mandrebern/TallyLight/eletronics/Rev A/Bill of Materials TallyLight.xlsx

 | Bill Of Materials |  |  | André-Netline |  |  |  |  |  |  | Confidential & Proprietary
 | Source Data From: |  |  | TallyLight.BomDoc
 | Variant: |  |  | None
 | Revision:
 | Report Date: |  |  | 14.08.2022 | 18:05
 | Print Date: |  |  | 2022-08-14 | 18:08:35
# | Designator | Name | Manufacturer | Manufacturer Part Number | Description | Supplier 1 | Supplier Part Number 1 | Footprint | Fitted | Quantity | Fitted Qty
1 | J2, J3 | BM03B-SRSS-TB | JST | BM03B-SRSS-TB(LF)(SN) | CONN HEADER SMD 3POS 1MM | Digi-Key | 455-1789-1-ND | BM03B-SRSS-TB | Fitted | 2 | 2
2 | U1 (2x) | LolinD32Pro | Sullins | PPPC161LFBN-RC | ESP32 board |  |  | LolinD32Pro | Fitted | 2 | 2
3 | J1 | Header 5 |  |  | Header, 5-Pin |  |  | HDR1X5 | Not Fitted | 1 | 0
4 | MT1, MT2, MT3, MT4 | Mount 3.2mm |  |  | Mounting hole 3.2mm, 5.7mm pad |  |  | MT | Not Fitted | 4 | 0
5 | BT1 (2x) | Battery | Keystone Electronics | 54 | Multicell Battery |  |  | Bat18650B | Fitted | 2 | 2
6 | R7, R8 | 10E | Panasonic | Stackpole Electronics Inc | RES 10 OHM 1% 1/10W 0603 |  |  | R0603 | Fitted | 2 | 2
7 | R1, R2 | (1.5k) | Panasonic | ERJ-2RKF1501X | RES SMD 1.5K OHM 1% 1/10W 0402 | Newark | 85Y8121 | R0402 | Not Fitted | 2 | 0
8 | R5 | 10k | Panasonic | ERJ-2RKF1002X | RES SMD 10K OHM 1% 1/10W 0402 | Newark | 85Y8054 | R0402 | Fitted | 1 | 1
9 | R6 | 20k | Panasonic | ERJ-2RKF2002X | RES SMD 20K OHM 1% 1/10W 0402 | Newark | 12AC0974 | R0402 | Fitted | 1 | 1
10 | R3, R4 | 470E | Panasonic | ERJ-2RKF4700X | RES SMD 470 OHM 1% 1/10W 0402 | Newark | 85Y8343 | R0402 | Fitted | 2 | 2
11 | S2 | 500SSP1S1M6QEA | E-Switch | 500SSP1S1M6QEA | SWITCH SLIDE SPDT 5A 120V | Digi-Key | EG2478-ND | 500SSPxS2M6xEA | Fitted | 1 | 1
12 | S1 | SS075Q102F035V2A | E-Switch | SS075Q102F035V2A | SWITCH SNAP ACT SPDT 100MA 125V | Mouser | 612-SS075Q102F035V2A | SS075Q102F035V2A | Fitted | 1 | 1
 |  |  |  |  |  |  |  |  |  |  | 14
Approved by: |  |  |  | Notes:
 | Author: |  | Date: | The manufacturer part number takes precedence over any supplier part number.
 |  |  |  | All 0603 resistors and capacitors may be replaced by other manufacturer parts, as long as their value, tolerance, oparting temperature and voltage rating is the same or better.
 | Engineering: |  | Date:
 | Manufacturing: |  | Date: |  |  |  |  |  |  |  | André-Netline
 |  |  |  |  |  |  |  |  |  |  | Könizstr. 161
 |  |  |  |  |  |  |  |  |  |  | CH-3097 Liebefeld
 | QA: |  | Date:
