mandrebern/TallyLight/cad/tally_light.FCStd

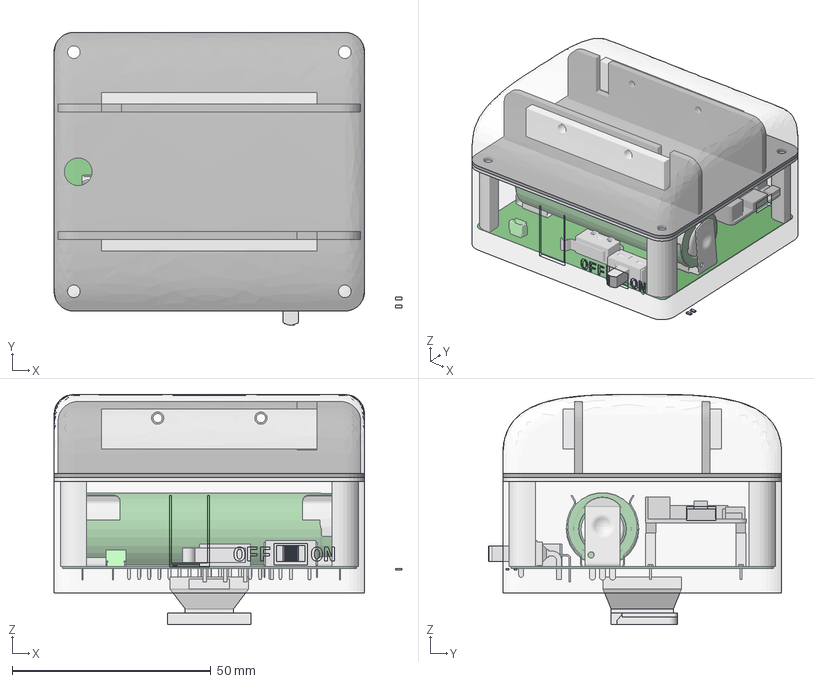
[picture p5: CAD file, 2022-08-04]
cad/tally_light.FCStd
87.6 x 73.8 x 58.0 mm
_____C161LFBN-RC
_____C161LFBN-RC001
wemos_d32_Pro
Extruded
Extruded001
500SSPxS2M6xEA
RES0603
RES0604
RES0402
RES0605
RES0606
BM03B-SRSS-TB
BM03B-SRSS-TB001
keystone-PN54
keystone-PN055
Top_cover_v1
LEDFront
LEDBack
LedHolder
BackCover
ElectronicsHolder
LightCover
MagnetAdapter
Sony_camera_flash_shoe_insert
