mandrebern/TallyLight/eletronics/Rev A/Schematic Print TallyLight.pdf

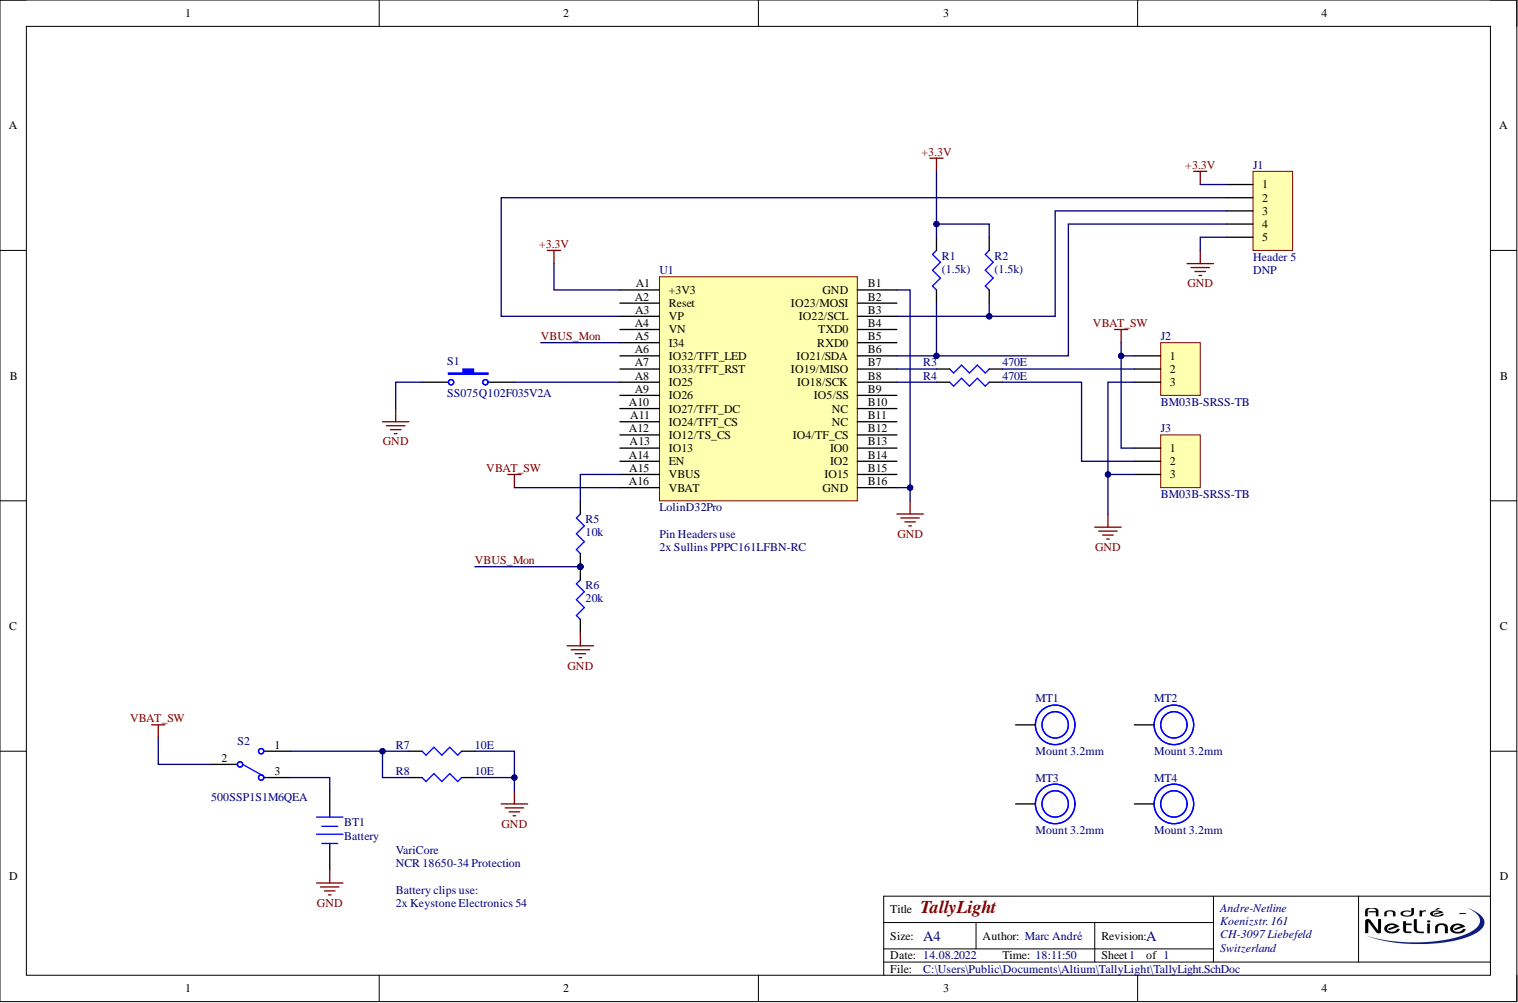
[picture p6: page 1]

C:\Users\Public\Documents\Altium\TallyLight\TallyLight.SchDoc
