mandrebern/TallyLight/(list of files, drawings)

Other design files:
eletronics/Rev A/Altium/TallyLight2.PcbDoc
eletronics/Rev A/Altium/TallyLight.PcbLib
eletronics/Rev A/Altium/TallyLight.PrjPcb
eletronics/Rev A/Altium/TallyLight.SchDoc
eletronics/Rev A/Altium/TallyLight.SchLib
