mandrebern/TallyLight/assembly/pictures/Rework_Charge.jpg

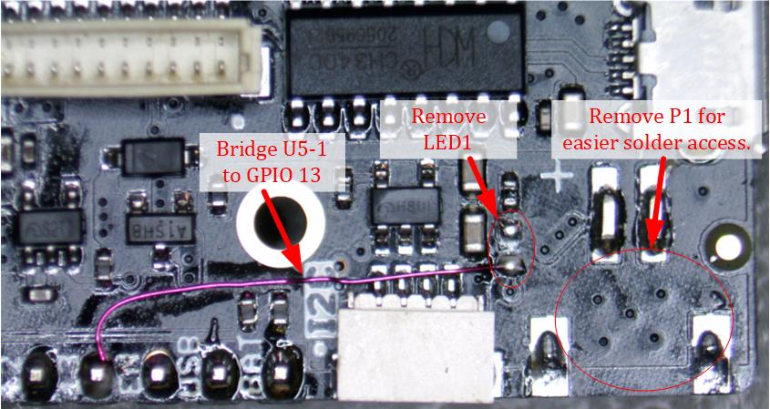
assembly/pictures/Rework_Charge.jpg
