mandrebern/TallyLight/eletronics/Battery Measurements/Battery_Measurement1.xlsx

No. | DateTime | Voltage(V) | Current(A) | Capacity(AH) | Percent Meas | Percent Calc
2 | 2022-08-14 22:53:41 | 4.0988 | 0.1000 | 0.00030 | 100.0% | 100.0%
3 | 2022-08-14 22:53:46 | 4.0985 | 0.1000 | 0.00044 | 100.0% | 99.9%
4 | 2022-08-14 22:53:51 | 4.0983 | 0.1000 | 0.00058 | 100.0% | 99.9%
5 | 2022-08-14 22:53:56 | 4.0981 | 0.1000 | 0.00072 | 100.0% | 99.9%
6 | 2022-08-14 22:54:01 | 4.0977 | 0.1000 | 0.00085 | 100.0% | 99.8%
7 | 2022-08-14 22:54:06 | 4.0976 | 0.1000 | 0.00100 | 100.0% | 99.8%
8 | 2022-08-14 22:54:11 | 4.0974 | 0.1000 | 0.00113 | 100.0% | 99.8%
9 | 2022-08-14 22:54:16 | 4.0972 | 0.1000 | 0.00128 | 100.0% | 99.8%
10 | 2022-08-14 22:54:21 | 4.0971 | 0.1000 | 0.00141 | 100.0% | 99.8%
11 | 2022-08-14 22:54:26 | 4.097 | 0.1000 | 0.00156 | 100.0% | 99.7%
12 | 2022-08-14 22:54:31 | 4.0969 | 0.1000 | 0.00169 | 99.9% | 99.7%
13 | 2022-08-14 22:54:36 | 4.0967 | 0.1000 | 0.00183 | 99.9% | 99.7%
14 | 2022-08-14 22:54:41 | 4.0967 | 0.1000 | 0.00197 | 99.9% | 99.7%
15 | 2022-08-14 22:54:46 | 4.0966 | 0.1000 | 0.00212 | 99.9% | 99.7%
16 | 2022-08-14 22:54:51 | 4.0965 | 0.1000 | 0.00225 | 99.9% | 99.7%
17 | 2022-08-14 22:54:56 | 4.0963 | 0.1000 | 0.00240 | 99.9% | 99.7%
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
