mandrebern/TallyLight/eletronics/Battery Measurements/Battery_Measurement2.xlsx

No. | DateTime | Voltage(V) | Current(A) | Capacity(AH) | Capacity
2 | 2022-08-16 16:04:49 | 4.0874 | 0.0999 | 0.00014 | 100.0%
3 | 2022-08-16 16:04:54 | 4.0867 | 0.1000 | 0.00027 | 100.0%
4 | 2022-08-16 16:04:59 | 4.0862 | 0.1000 | 0.00041 | 100.0%
5 | 2022-08-16 16:05:04 | 4.0857 | 0.1000 | 0.00055 | 100.0%
6 | 2022-08-16 16:05:09 | 4.0852 | 0.1000 | 0.00069 | 100.0%
7 | 2022-08-16 16:05:14 | 4.0848 | 0.0999 | 0.00083 | 100.0%
8 | 2022-08-16 16:05:19 | 4.0841 | 0.1000 | 0.00098 | 100.0%
9 | 2022-08-16 16:05:24 | 4.0836 | 0.1000 | 0.00111 | 100.0%
10 | 2022-08-16 16:05:29 | 4.0835 | 0.1000 | 0.00125 | 100.0%
11 | 2022-08-16 16:05:34 | 4.0832 | 0.0999 | 0.00139 | 100.0%
12 | 2022-08-16 16:05:39 | 4.0829 | 0.1000 | 0.00153 | 100.0%
13 | 2022-08-16 16:05:44 | 4.0829 | 0.0999 | 0.00167 | 99.9%
14 | 2022-08-16 16:05:49 | 4.0825 | 0.1000 | 0.00181 | 99.9%
15 | 2022-08-16 16:05:54 | 4.082 | 0.1000 | 0.00195 | 99.9%
16 | 2022-08-16 16:05:59 | 4.082 | 0.1000 | 0.00209 | 99.9%
17 | 2022-08-16 16:06:04 | 4.0816 | 0.1000 | 0.00223 | 99.9%
18 | 2022-08-16 16:06:09 | 4.0812 | 0.1000 | 0.00237 | 99.9%
19 | 2022-08-16 16:06:14 | 4.0809 | 0.0999 | 0.00251 | 99.9%
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
