mandrebern/TallyLight/(commit log)

2022-08-03 Initial CAD files and firmware
    [tally_light.FCStd]
2022-08-03 Increase height by 2mm and add on/off label
    [tally_light.FCStd]
2022-08-04 Add logo
    [tally_light.FCStd]
2022-08-10 Fix exceptions caused by FastLED
    Add labels to cad model
    [main.cpp]
2022-08-14 Extend firmware:
    - Add charging indicator
    - Set brightness from remote
    - Fix race condition during startup
    [main.cpp]
2022-08-14 Improvments:
    - Switch colors for preview/live
    - Implement default values
    - Allow disabling preview on front
    - Indication LED if no state is shown
2022-08-14 Add PCB data
    [Bill of Materials TallyLight.xlsx, TallyLight.PcbLib, TallyLight.PrjPcb, TallyLight.SchDoc, TallyLight.SchLib, TallyLight2.PcbDoc]
2022-08-14 Add assembly information
2022-08-15 Improve battery charge indicator
    - Separate led state handling for front and back
    - Smooth battery voltage readings
2022-08-20 Improve battery state display on leds and website
2022-08-20 Periodically update battery voltage
2022-08-20 Improve battery handling
    Can only be charging if USB powered. Otherwise, pin might be floating and falsely incidate charging.
    USB power is at 1V if powered via battery. This is outside spec of VL. Use ADC to indicate power state.
2022-08-20 Fix problem with white LED, add alive LED flash
    [main.cpp]
2022-08-20 Add setting for preview on back side, fix preview on front side
    Allow disabling the back side as well.
    Make both settings persistent.
    Fix UI to read back the current state.
    [main.cpp]
2022-08-21 Improve ADC reading for battery voltage
    See here: https://docs.espressif.com/projects/esp-idf/en/v4.1.1/api-reference/peripherals/adc.html
2022-08-22 Fix default VREF value
    Should not be used as our ESP have the vref calibrated. This is why I am not increasing the version number.
    [main.cpp]
2023-01-09 Added Rework to detect charge state
2023-01-09 Added measurement data for the voltage-charge curve
    [Battery_Measurement1.xlsx, Battery_Measurement2.xlsx]
